szbeni/solar/vanbot/README.MD

Vanbot

Python3 motion detector app which is running on a raspberry PI.
Motion detection will detect any movement inside the van and sends message via Telegram Messenger to mobile.
TODO Will merge it with the solar charge controller project.
