szbeni/solar/hw/docs/700px-Bluepillpinout.gif

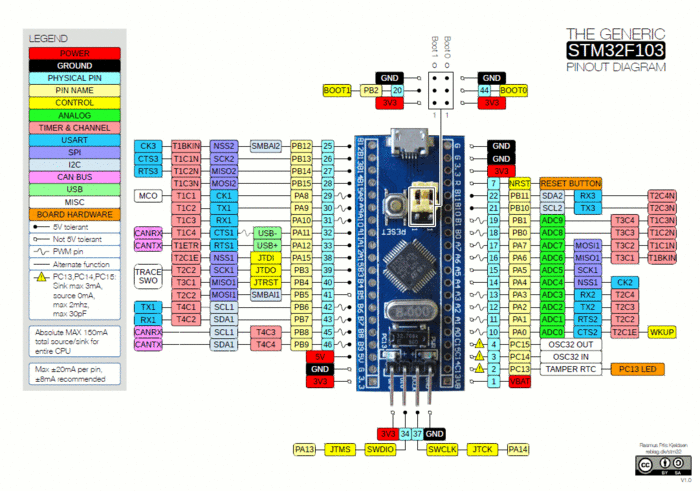
hw/docs/700px-Bluepillpinout.gif
