szbeni/solar/hw/docs/bluetooth.jpg

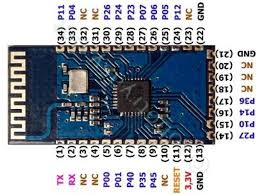
hw/docs/bluetooth.jpg
