szbeni/solar/res/prototype02.jpg

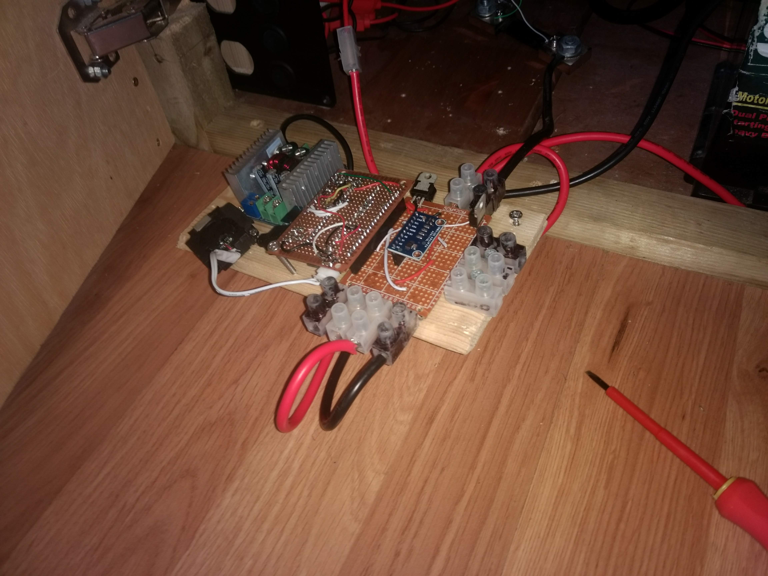
res/prototype02.jpg
