szbeni/solar/(threads)

Thread 1 (2021-01-20):

PDF outputs from your KiCad documents?

rin67630, 2021-01-20:
Hi,

could you please add PDF outputs from your KiCad documents?
Not everyone has the software...

Thank you.

szbeni, 2021-01-20:
I have added the schematic of the design as PDF. Hope you find it useful.

rin67630, 2021-01-28:
Thank you!

Closed 2021-01-21.

Thread 2 (2022-11-16):

Issue on the build debug

willcossak, 2022-11-16:
I can't build "debug" on the project (I attached the screenshot of the issue on the IDE)

Console write :
make: *** [Src/usr/subdir.mk:40: Src/usr/solar.o] Error 1
make: *** Waiting for unfinished jobs....
make: *** [Src/usr/subdir.mk:40: Src/usr/solar_fan.o] Error 1
../Src/usr/solar_comm.c:1:10: fatal error: main.h: No such file or directory

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

szbeni, 2022-11-16:
I havn't used Cube-IDE for my projects. I usually use vscode or command line to make.
But it looks like you are missing include directory path in your IDE project.

willcossak, 2022-11-16:
I'll try with vscode thank you !

szbeni, 2022-11-16:
updated to STM32Cube_FW_F1 v1.8.4 and added a Cube IDE project file, should  be able to import it and compile.

Closed 2022-11-16.
