szbeni/solar/hw/docs/SZBK07_30.pdf

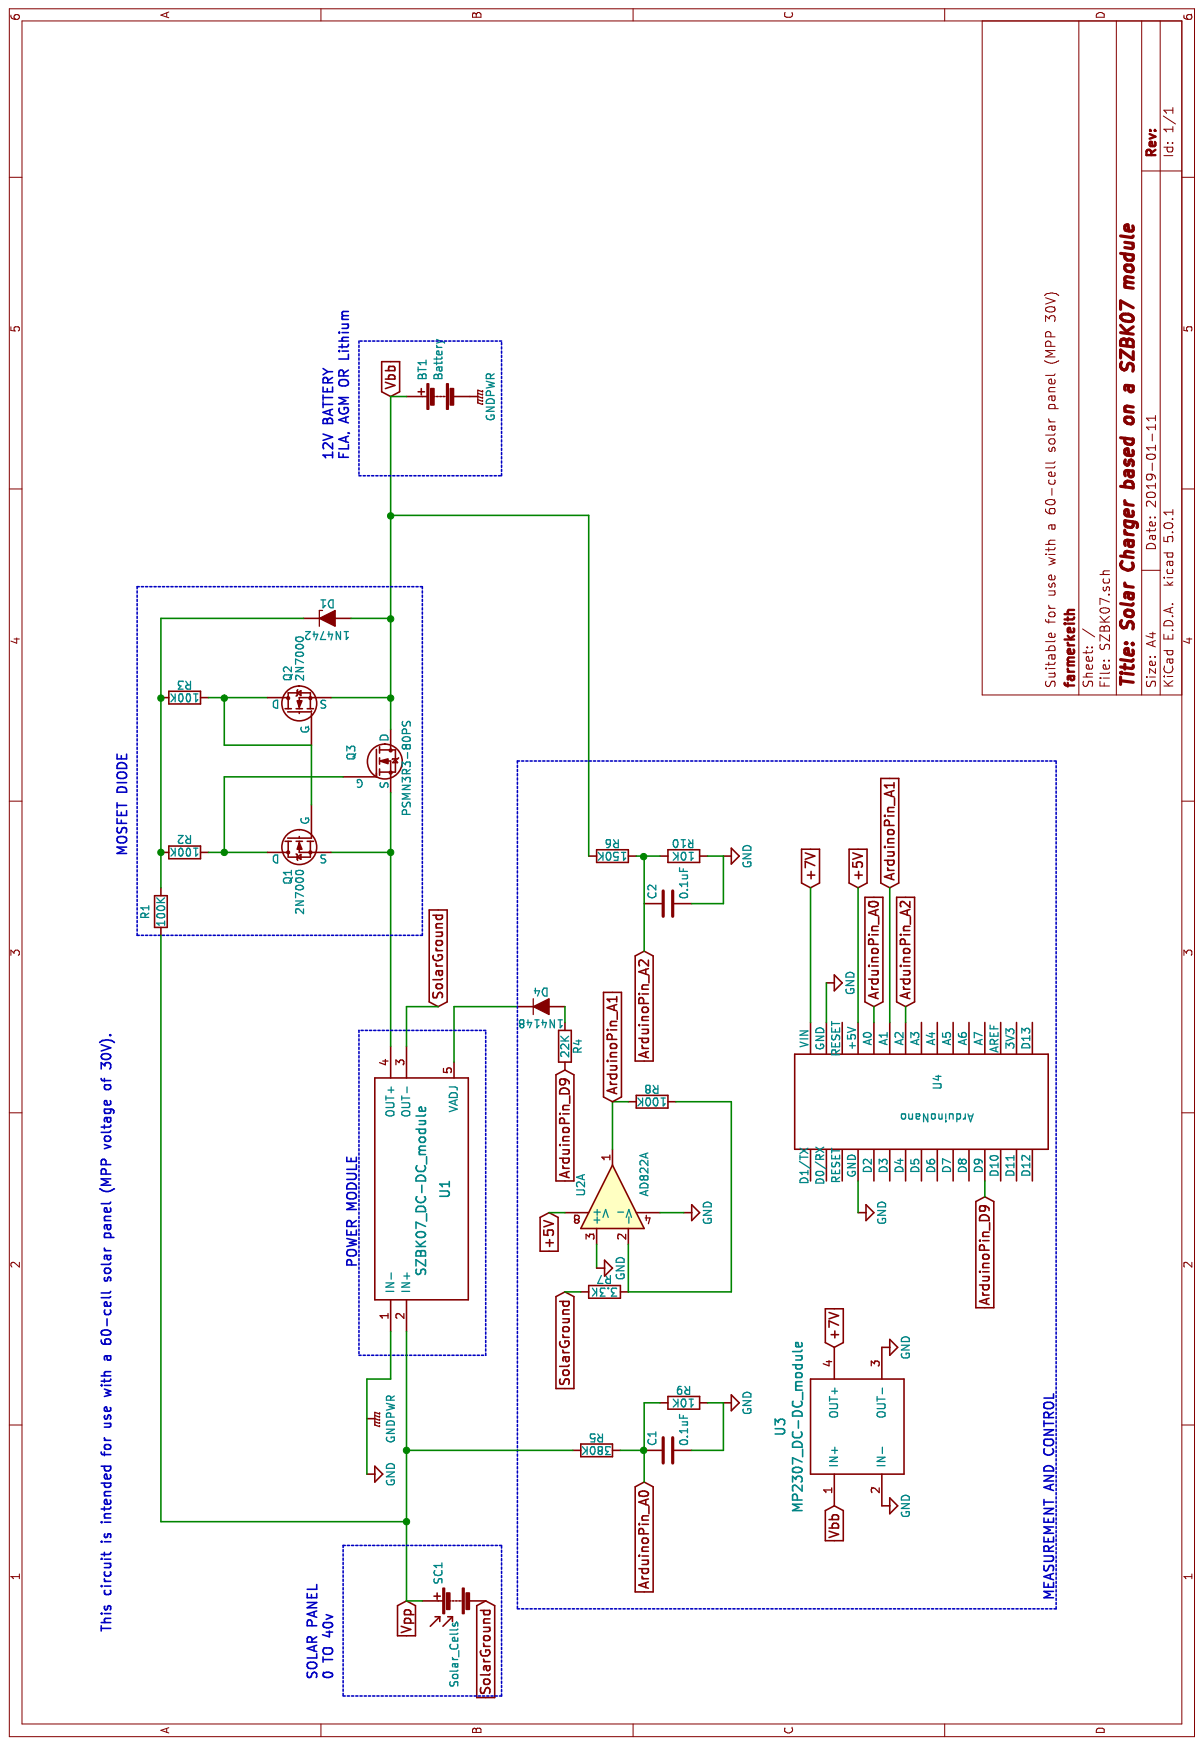
[picture p9: page 1]
