szbeni/solar/webapp/solar_serial.py

from threading import Thread
from solar_data import SolarData
import serial
from time import sleep
import time
from pynng import Pub0, Sub0, Pair1, TryAgain

class SolarSerial(Thread):
    def __init__(self, settings):
        super().__init__()
        self.running = False
        self.settings = settings
        self.serial = None
        self.connected = False
        self.pubSocket = Pub0()
        self.msgSocket = Pair1(polyamorous=True)
        self.firstDataReceived = False
        self.lastDataTime = time.time()

    def openSerial(self):
        if self.serial is not None:
            self.serial.close()
            self.serial = None
        try:
            self.serial = serial.Serial(self.settings['port'], self.settings['baud'], timeout=5000)
            self.connected = True
        except Exception as e:
            print("Error opening serial port:", self.settings['port'])
            print("Exception: {0}".format(e))
            self.connected = False
        
    def closeSerial(self):
        if self.serial is not None:
            self.serial.close()
            self.serial = None
        self.connected = False

    def stop(self):
        self.closeSerial()
        self.running = False
        self.pubSocket.close()
        self.msgSocket.close()

    def handle_data(self, data):
        sd = SolarData(data)
        if sd.initalized:
            if self.firstDataReceived == False:
                self.firstDataReceived = True
                print(data)
            self.lastDataTime = time.time()
            self.pubSocket.send(sd.to_byte())
        else:
            print("Cannot parse data: ", data)
        pass

    def run(self):
        self.running = True
        self.pubSocket.listen(self.settings['address_pub'])
        self.msgSocket.listen(self.settings['address_msg'])

        while self.running:
            self.openSerial()
            data = ""
            while self.connected:
                delta_t = time.time() - self.lastDataTime
                if delta_t > self.settings['no_data_restart_time']:
                    print("No recevied data for more than {0} seconds".format(delta_t))
                    self.stop()
                    break
                try:
                    received_data = self.serial.readline().decode()
                except Exception as e:
                    print("Failed to read data: {0}".format(e))
                    received_data = None
                if received_data:
                    data += received_data
                    if '\r\n' in data:
                        sliced = data.split('\r\n')
                        data = ''.join(sliced[1:])
                        self.handle_data(sliced[0])
                try:
                    send_data = self.msgSocket.recv(block=False)
                    self.serial.write(send_data)
                except TryAgain:
                    #no data
                    pass
                sleep(0.01)
            sleep(5)
        print("Exiting")

if __name__ == "__main__":
    from solar_settings import SolarSettings
    ss = SolarSerial(SolarSettings.serial_settings)
    ss.start()
    ss.join()
