szbeni/solar/fw/bluepill.ioc

Mcu.UserName=STM32F103CBTx
PA0-WKUP.Signal=ADCx_IN0
PA1.Signal=ADCx_IN1
PA10.GPIO_Label=PWM_DCDC_ENABLE
PA10.Signal=GPIO_Output
PA13.Signal=SYS_JTMS-SWDIO
PA14.Signal=SYS_JTCK-SWCLK
PA2.Signal=ADCx_IN2
PA3.Signal=ADCx_IN3
PA4.Signal=ADCx_IN4
PA7.GPIO_Label=SWITCH_FAN
PA7.Signal=S_TIM3_CH2
PA8.GPIO_Label=PWM_DCDC
PA8.Signal=S_TIM1_CH1
PA9.GPIO_Label=PWM_DCDC_SD
PA9.Signal=S_TIM1_CH2
PB0.GPIO_Label=SWITCH_LOAD
PB0.Signal=GPIO_Output
PB10.Signal=I2C2_SCL
PB11.Signal=I2C2_SDA
PB13.GPIO_Label=PWM_DCDC_N
PB13.Signal=TIM1_CH1N
PB6.Signal=USART1_TX
PB7.Signal=USART1_RX
PC13-TAMPER-RTC.GPIO_Label=BUILTIN_LED
PC13-TAMPER-RTC.Signal=GPIO_Output
PC14-OSC32_IN.Signal=RCC_OSC32_IN
PC15-OSC32_OUT.Signal=RCC_OSC32_OUT
PD0-OSC_IN.Signal=RCC_OSC_IN
PD1-OSC_OUT.Signal=RCC_OSC_OUT
