szbeni/solar/fw/Inc/main.h

#define BUILTIN_LED_Pin GPIO_PIN_13
#define BUILTIN_LED_GPIO_Port GPIOC
#define SWITCH_FAN_Pin GPIO_PIN_7
#define SWITCH_FAN_GPIO_Port GPIOA
#define SWITCH_LOAD_Pin GPIO_PIN_0
#define SWITCH_LOAD_GPIO_Port GPIOB
#define PWM_DCDC_N_Pin GPIO_PIN_13
#define PWM_DCDC_N_GPIO_Port GPIOB
#define PWM_DCDC_Pin GPIO_PIN_8
#define PWM_DCDC_GPIO_Port GPIOA
#define PWM_DCDC_SD_Pin GPIO_PIN_9
#define PWM_DCDC_SD_GPIO_Port GPIOA
#define PWM_DCDC_ENABLE_Pin GPIO_PIN_10
#define PWM_DCDC_ENABLE_GPIO_Port GPIOA
