szbeni/solar/(commit log)

2019-07-27 initial code
    [solar.kicad_pcb, solar.sch]
2019-08-14 refractor delet
    [solar.kicad_pcb, solar.sch]
2019-08-19 added sample settings py
2019-09-10 multi camera support
2019-09-10 select camera
2019-09-17 added ads1115 to hw, launch and debug task editied for vscode
    [solar.sch]
2019-09-21 added ads1115 to hardware, mppt algorithm started
    [solar.sch]
2019-09-22 added fan for solar controller, fixed bug in mini snprintf float, added mppt algorith
    [solar.sch]
2019-09-22 added photos of prototype
2019-09-23 power switching circuitry added
    [solar.sch]
2019-09-26 mppt algorithm TODO add current control when battery is full
2019-09-28 added state machine for MPPT, OFF, MAXP, FLOAT Charge states
2019-09-28 added temporary current sensor
    [solar.sch]
2019-09-29 float charging control algorithm fix added readme and pics from webapp
    [solar.h, solar_data.py, solar_mppt.c]
2019-10-02 vabot segmentation fault fix, when trying to open camera from 2 threads at the same time.. TODO investigate, now just added a delay
2019-10-05 android app progress, modified mppt algorithm to protect agains over voltage the load and battery, should do a hardware cut off if battery voltage is high cut off DCDC...
2019-10-06 started to make Tk gui for raspberry pi, TODO refractor code..
2019-10-08 solar firmware I2C reset if connection is not working
    [solar.c, solar.h, solar_ads1115.c]
2019-11-25 added load switch off counter
2019-12-13 solar current adc calibrated
2020-03-06 added high current threshold
2020-05-03 power stage testing.
    [solar.sch]
2020-05-11 added IR2104 so can implement diode emulation
    [solar.sch]
2020-06-08 added battery over voltage protection if solar DCDC is damaged
    [solar.sch]
2021-01-20 tidy up schematic and added pdf# Please enter the commit message for your changes. Lines starting
    [powerstage.sch, powerstage_nogatedrive.sch, solar.sch]
